tsaG1337/mEFIS/hardware/mainboard_rev.1.1.pdf

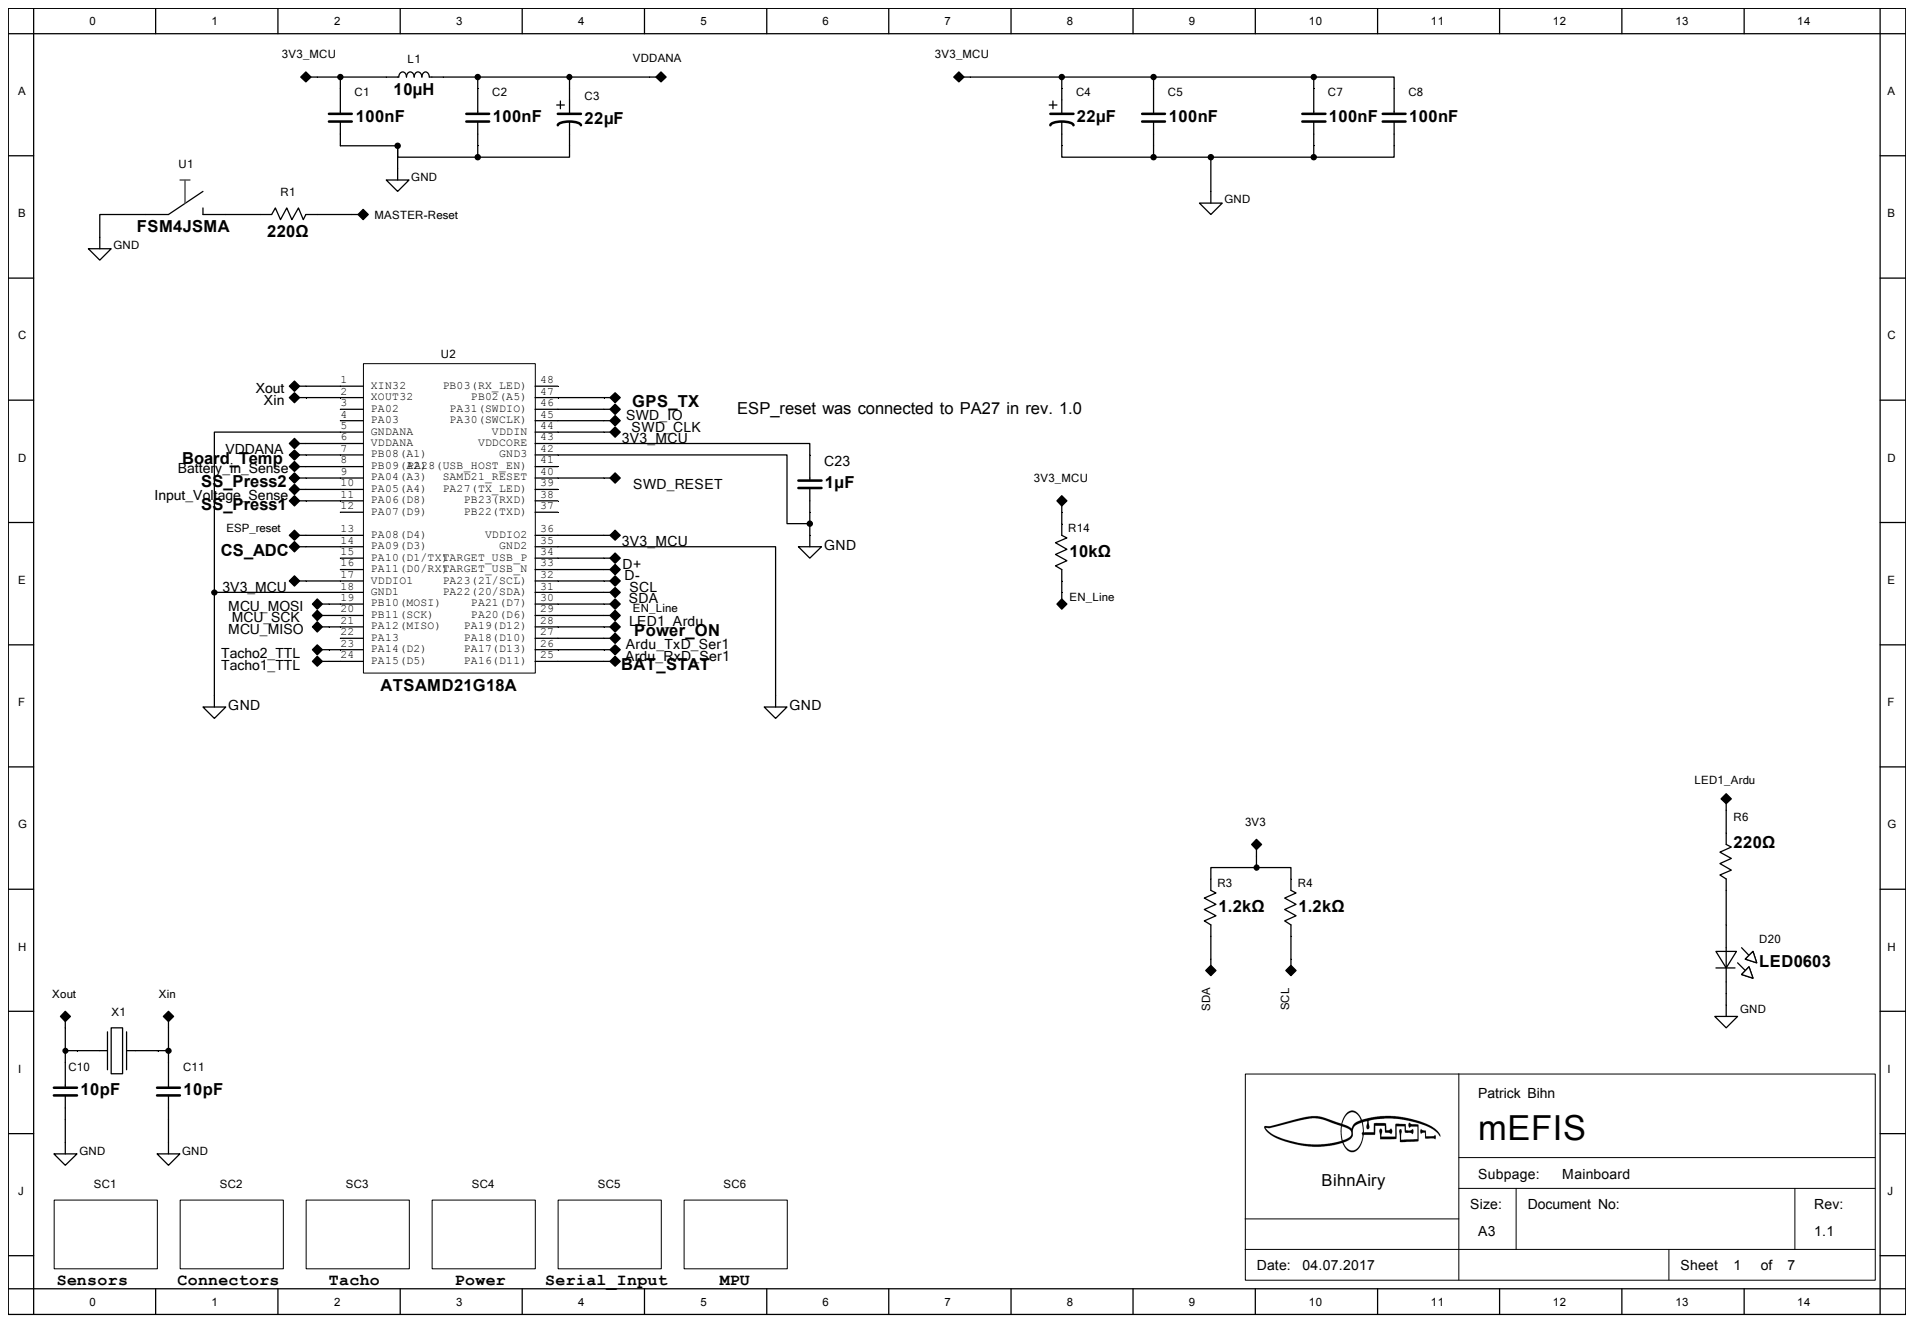
[picture p1: page 1]

ESP_reset was connected to PA27 in rev. 1.0

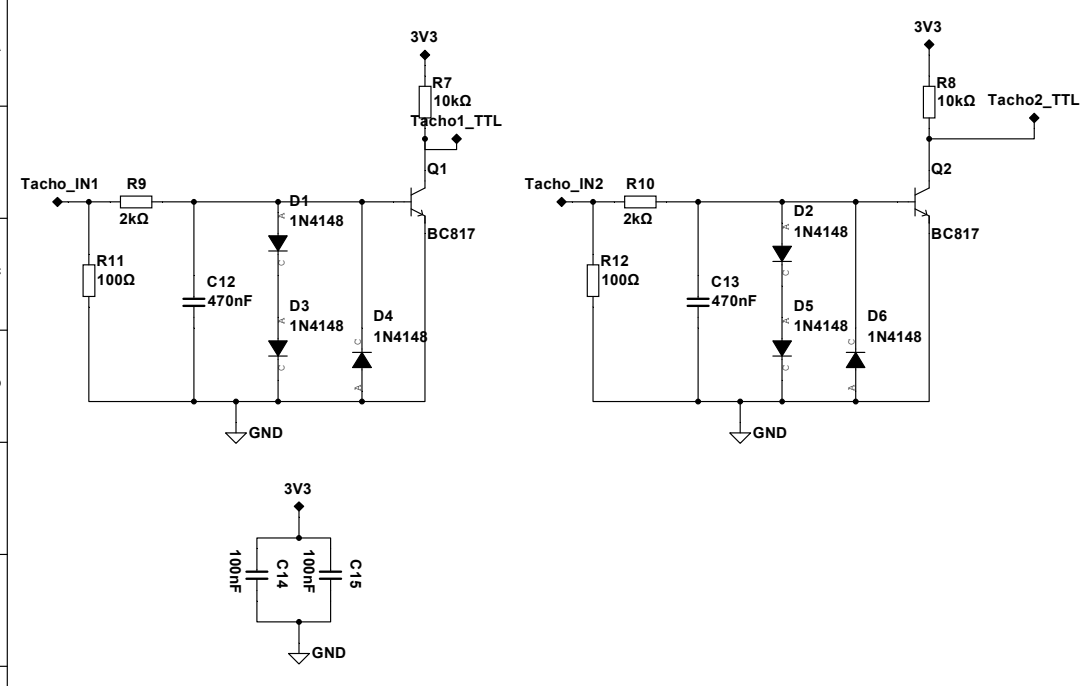
[picture p2: page 2]

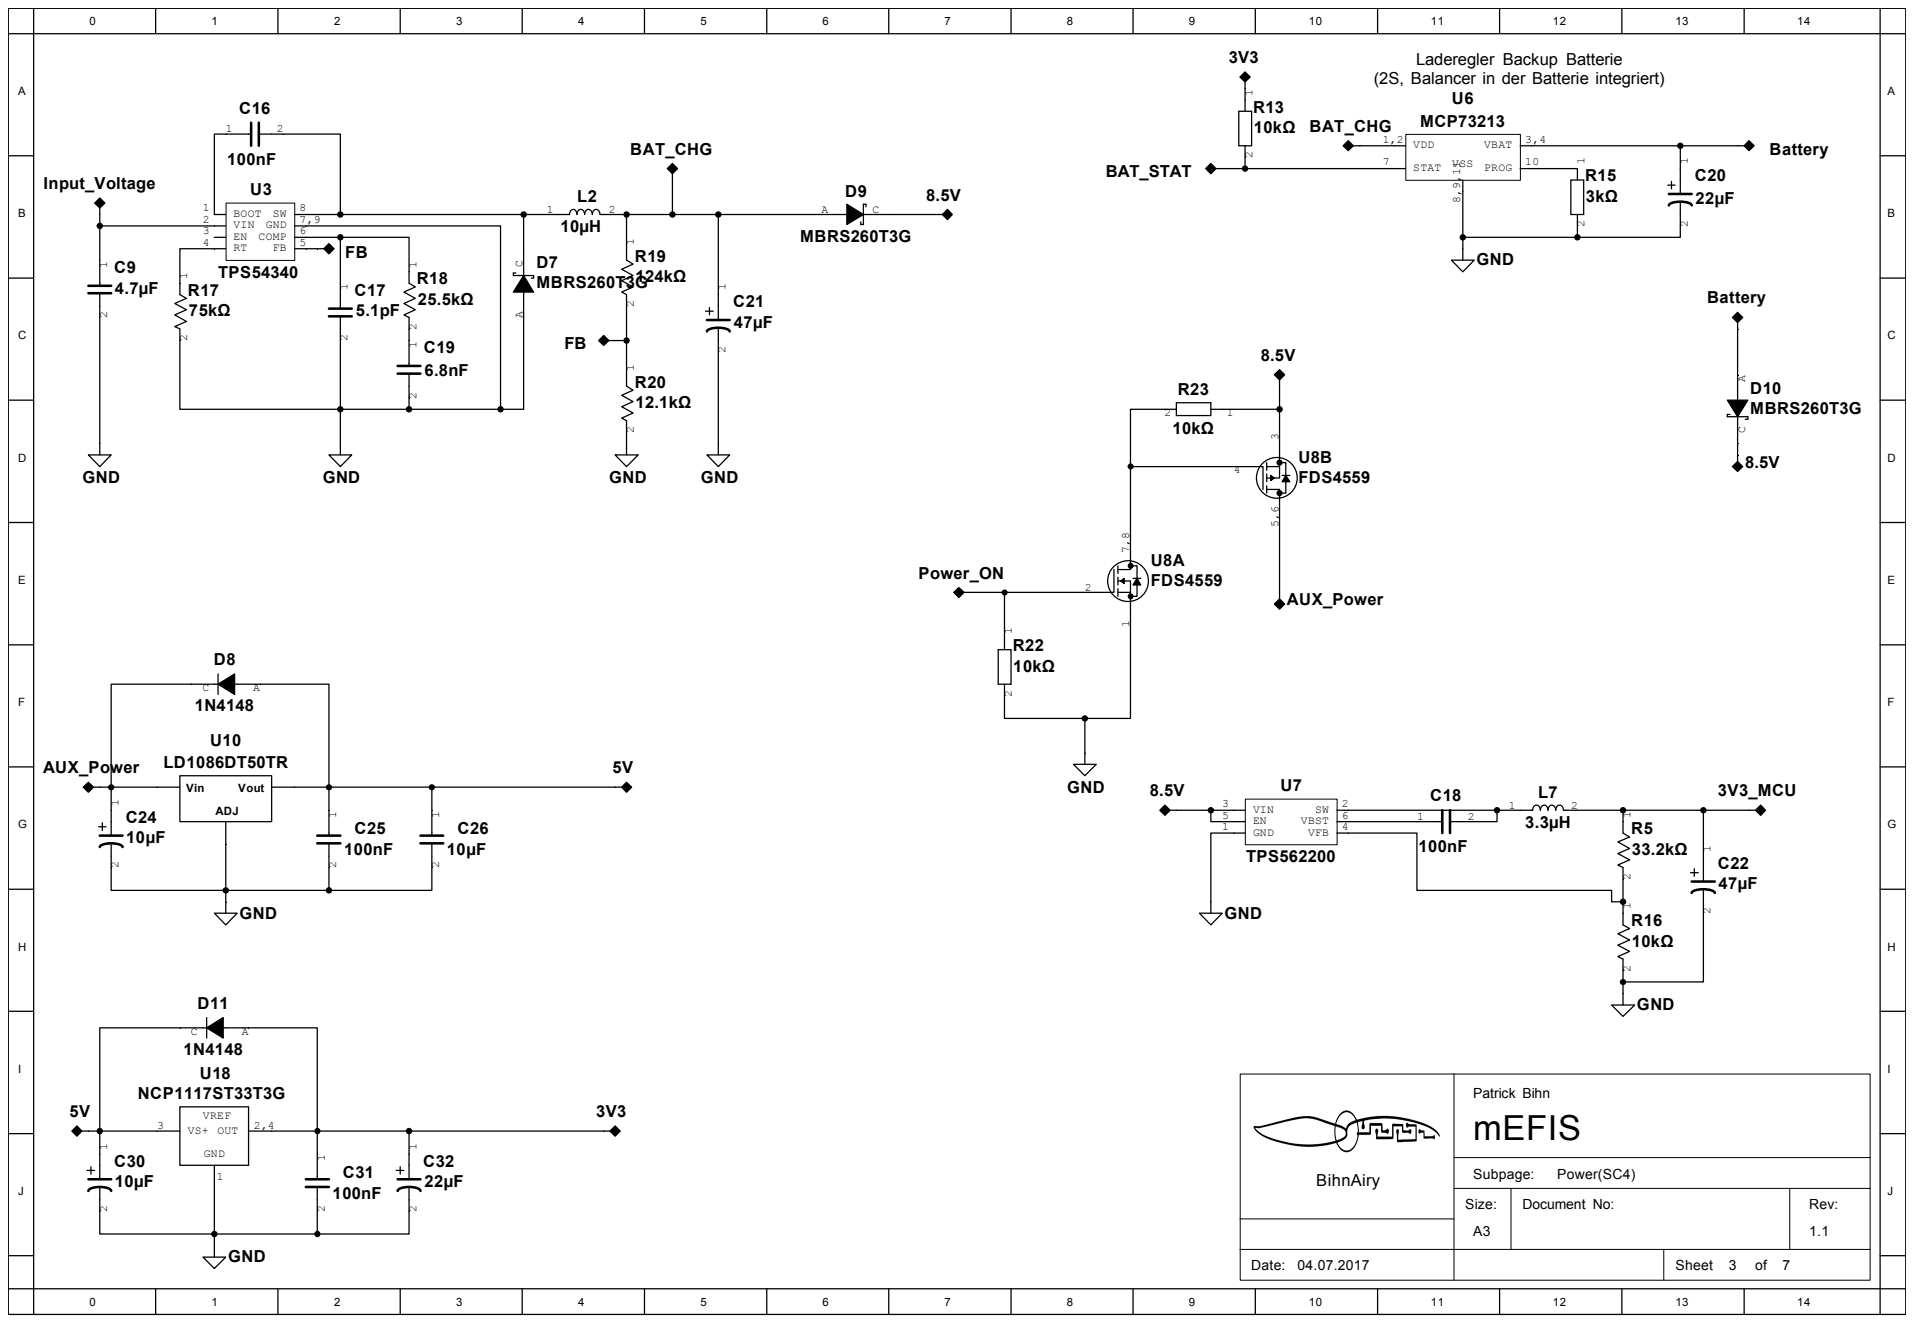
[picture p3: page 3]

(2S, Balancer in der Batterie integriert)

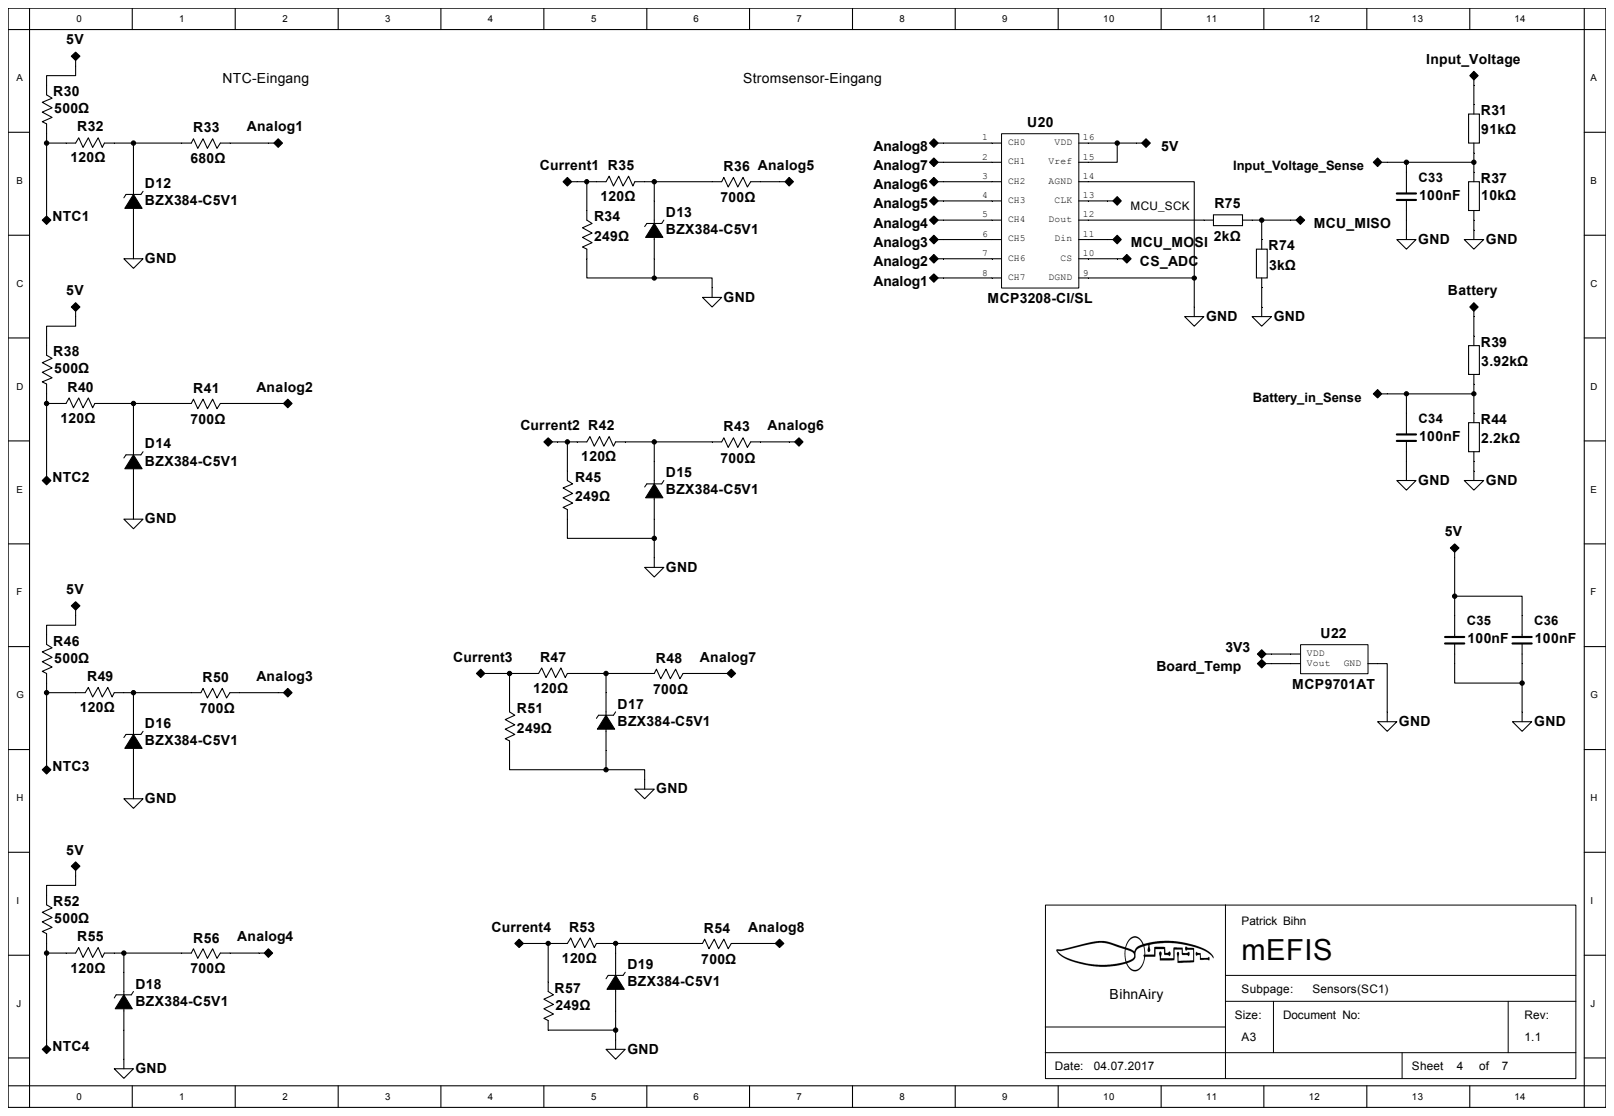
[picture p4: page 4]

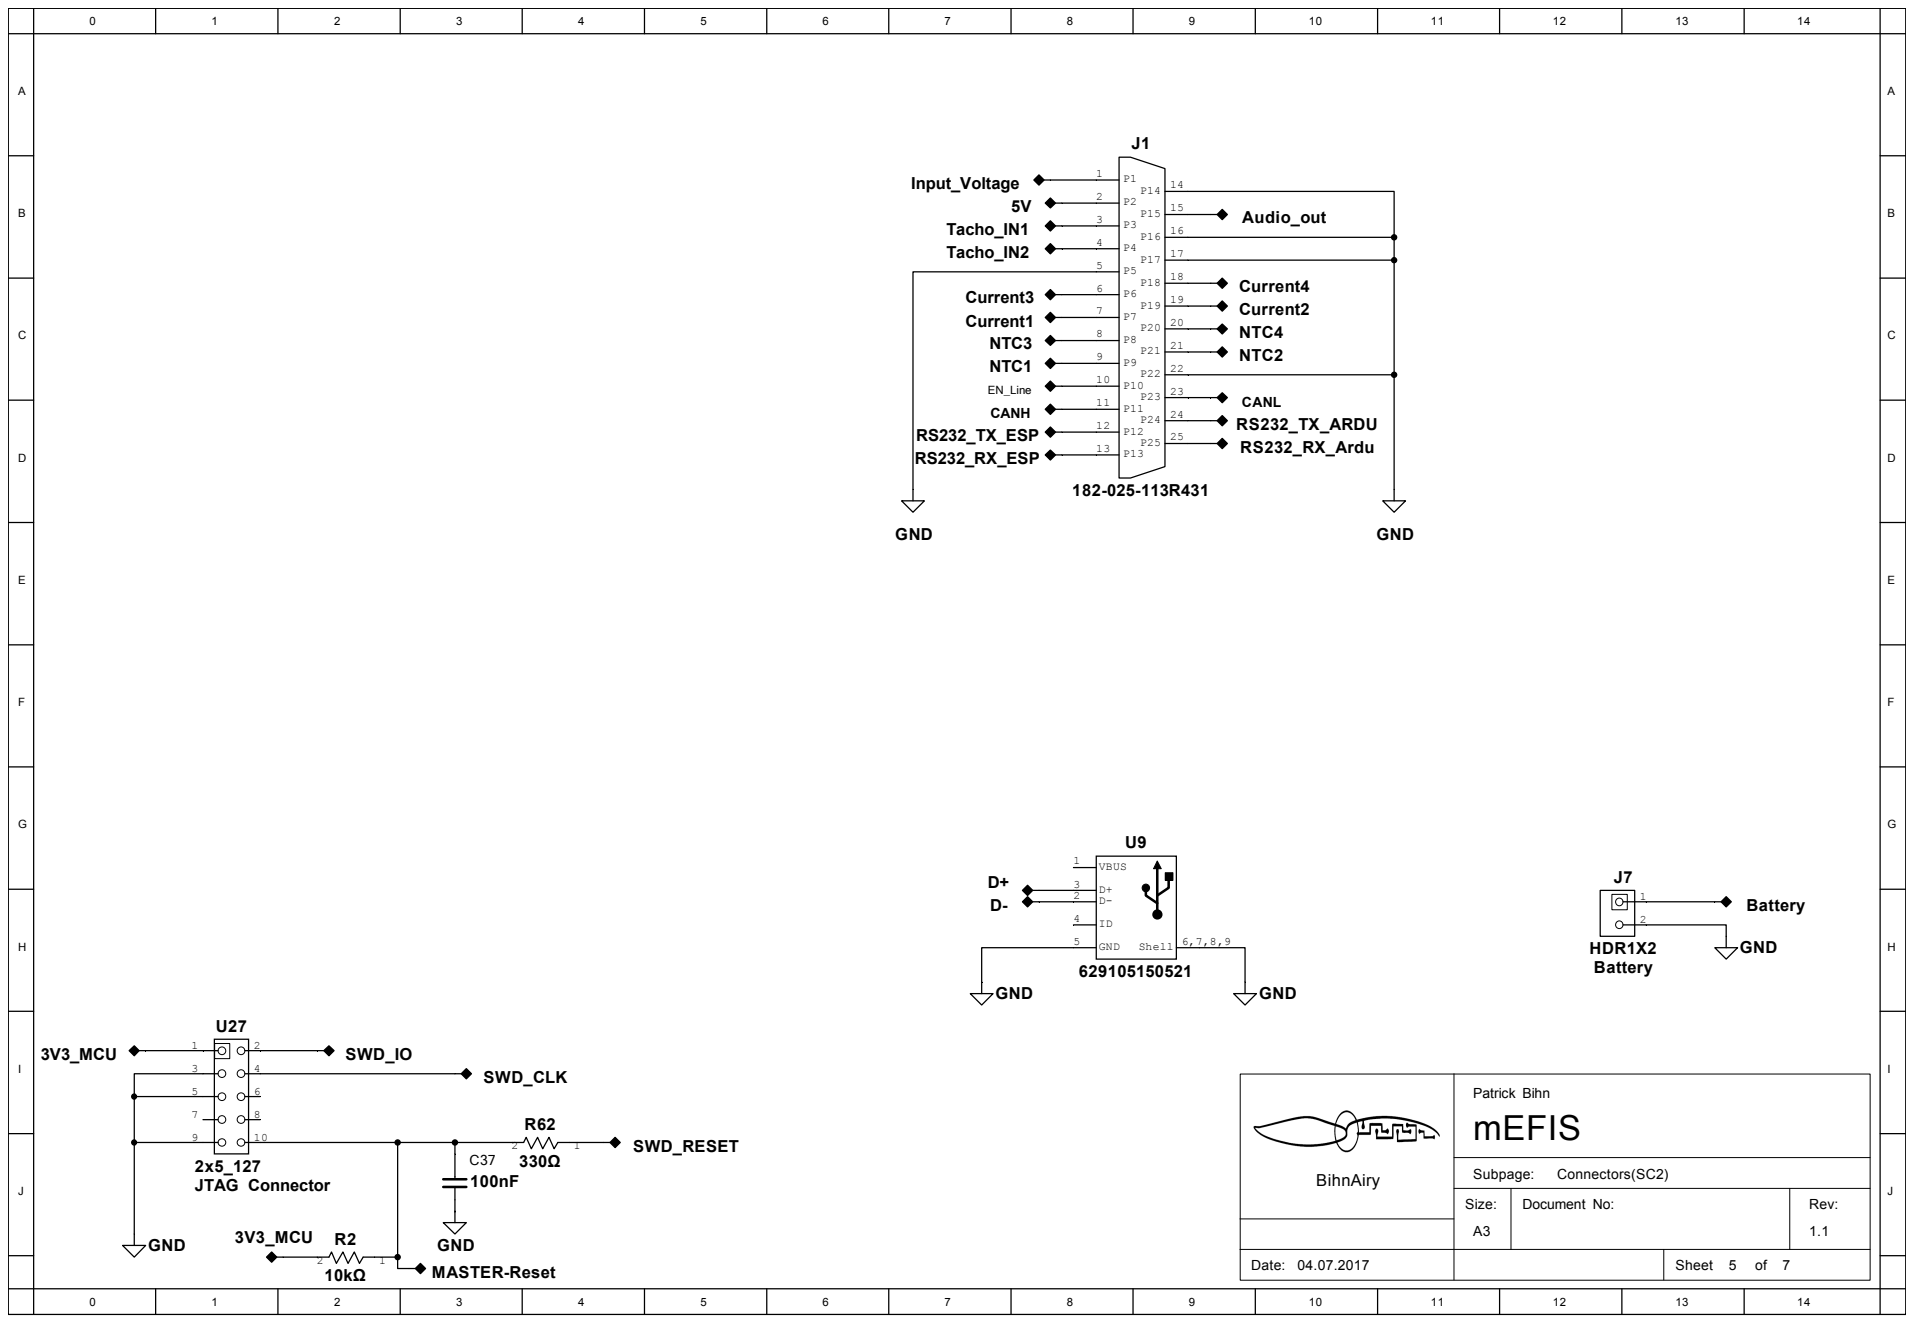
[picture p5: page 5]

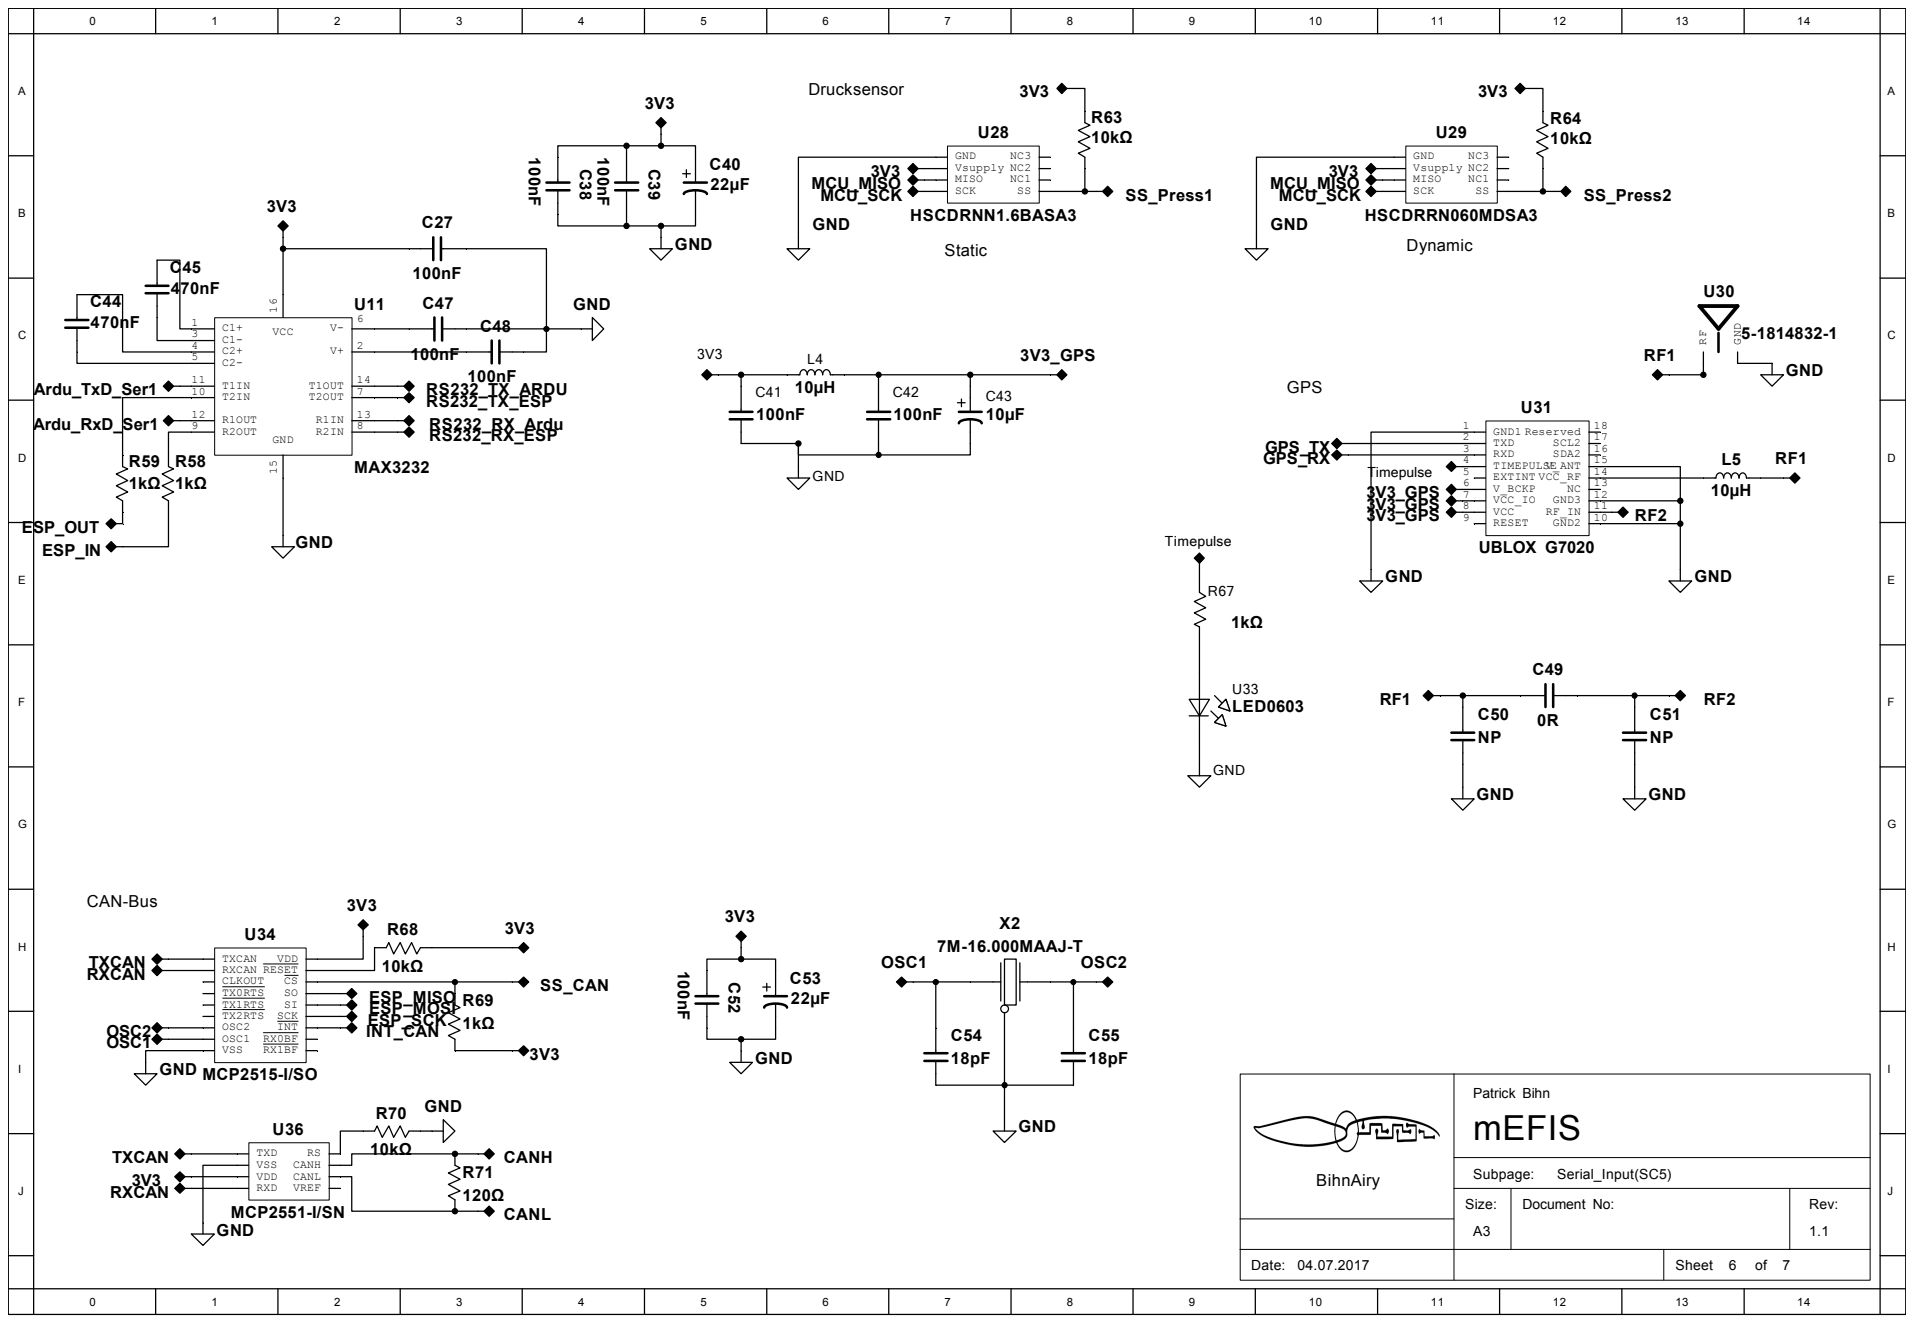
[picture p6: page 6]

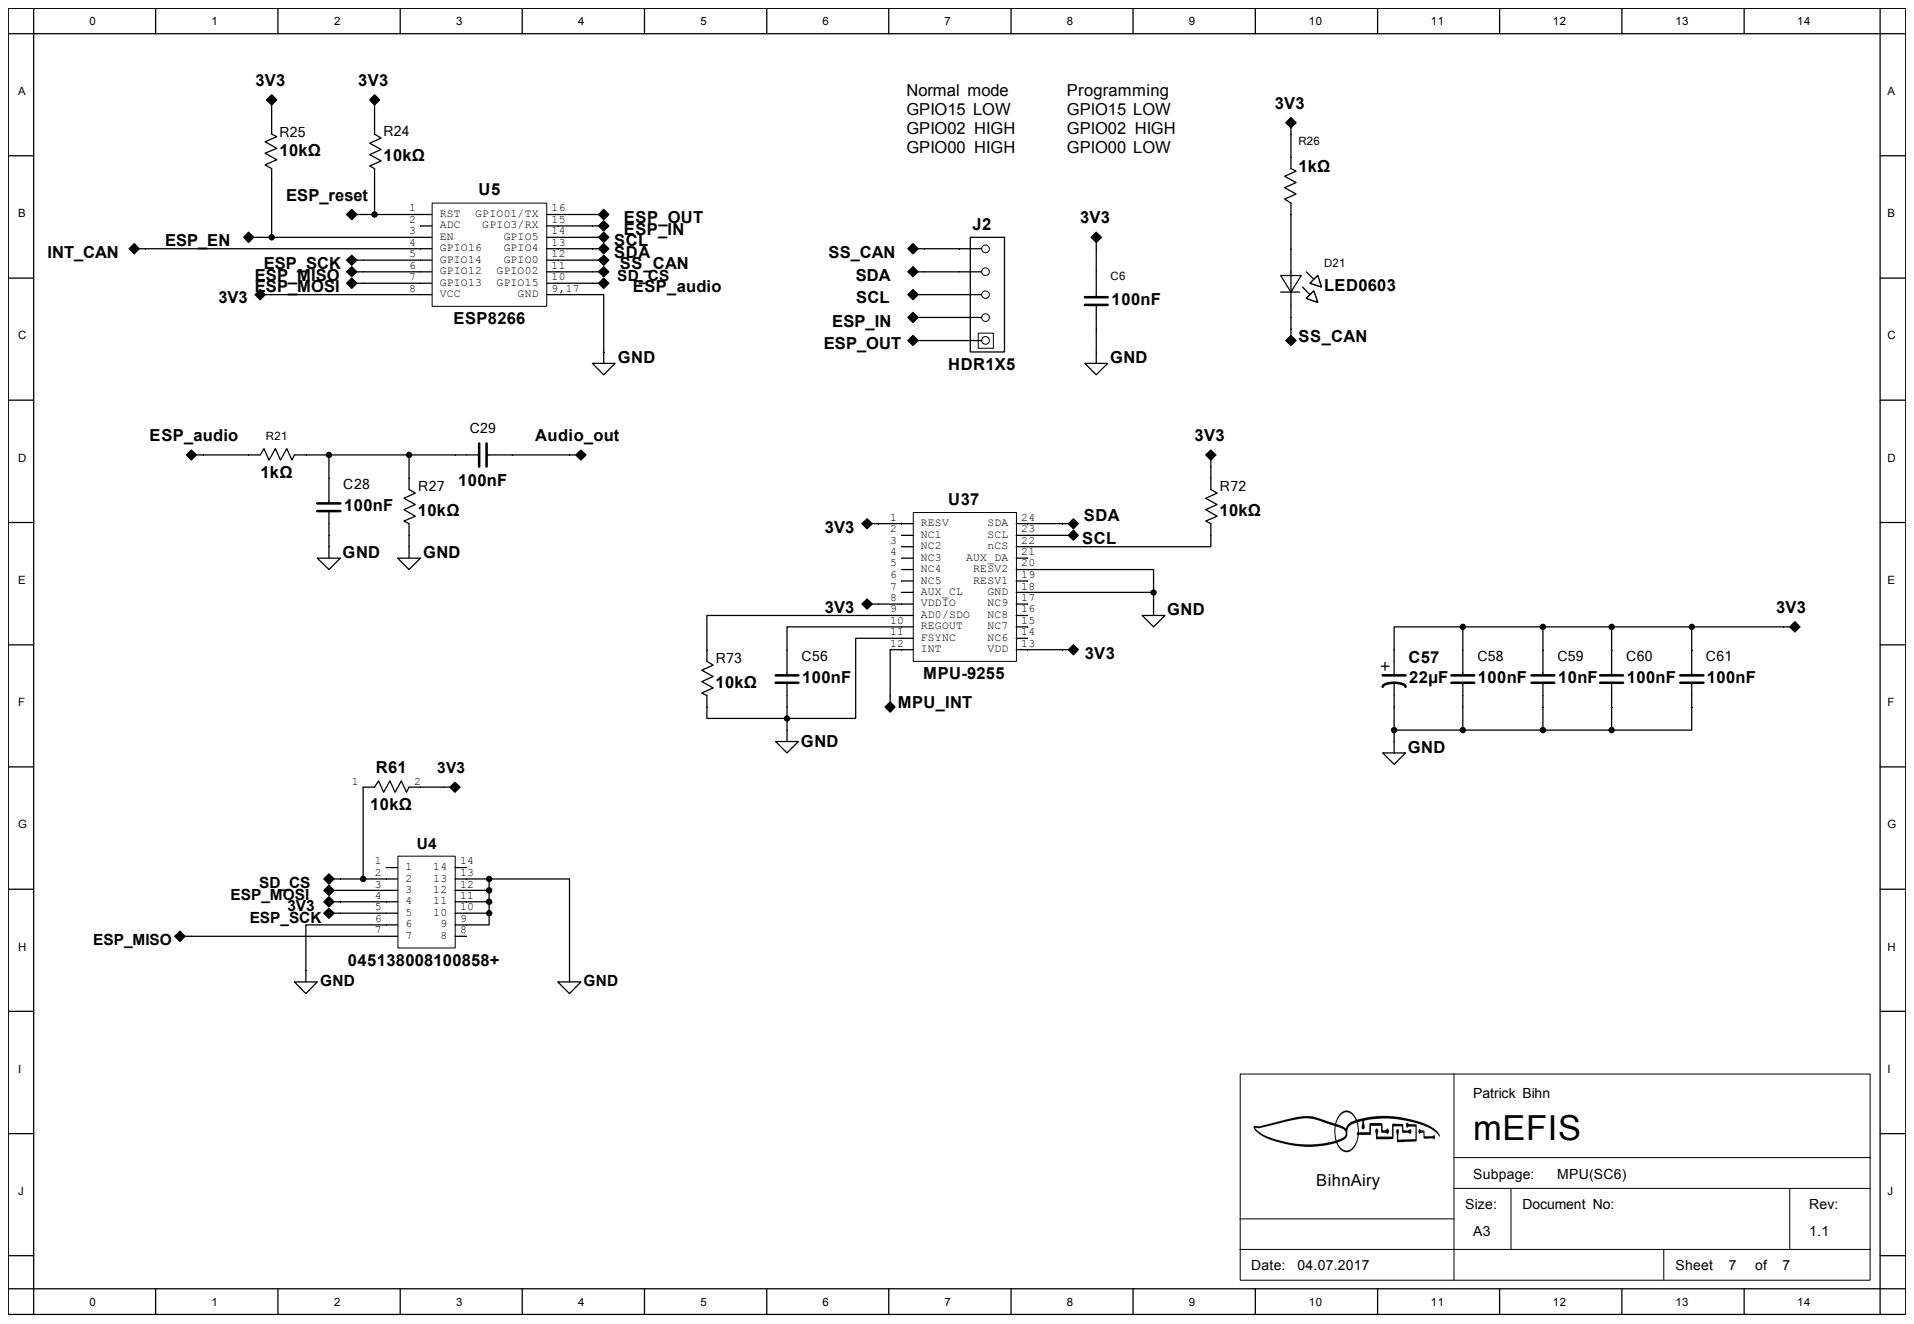
[picture p7: page 7]
