tsaG1337/mEFIS/firmware/dsp_core/HSS.cpp

/*
  mEICAS - my Engine Indicating Crew Alerting System.
  Copyright (C) 2017 Patrick Bihn <pbihn at uni minus bremen dot de>

  You can find the full repo here:
  https://github.com/tsaG1337/mEFIS

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
*/
#include "HSS.h"
#include "Arduino.h"
#include "SPI.h"
#define DEBUG "HSS"
#include "debug.h"

//Define Communication Settings
#define baudrate 500000
#define BitFirst MSBFIRST
#define SPIMode SPI_MODE3



HSS::HSS(uint8_t ChipSelect, int16_t low, int16_t high) {
  lowPressure = low;
  highPressure = high;
  ChipselectPin = ChipSelect;


}


int HSS::getTemperature() {
  return temperature;
}


int16_t HSS::getPressure() {
  return pressure;
}


void HSS::readSensor() {
  SPI.beginTransaction(SPISettings(baudrate, BitFirst, SPIMode)); // Set to 800kHz, MSB and MODE1
  SPI.begin();
  digitalWrite(ChipselectPin, LOW);       //pull Chipselect Pin to Low

  inByte_1 = SPI.transfer(0x00);  // Read first Byte of Pressure
  //delayMicroseconds(10);
  inByte_2 = SPI.transfer(0x00);  // Read second Byte of Pressure
  //delayMicroseconds(10);
  inByte_3 = SPI.transfer(0x00);  // Read first Byte of Temperature
  //delayMicroseconds(10);
  inByte_4 = SPI.transfer(0x00);  // Read second Byte of Temperature
  //LOG("SPI END Transaction");
  SPI.endTransaction();               //end SPI Transaction
  //LOG("SPI END");
  SPI.end();

    //LOG("Chipselect = ",ChipselectPin);
    //LOG("Byte_1 = ",inByte_1);
    //LOG("Byte_2 = ",inByte_2);
    //LOG("Byte_3 = ",inByte_3);
    //LOG("Byte_4 = ",inByte_4);
 
  digitalWrite(ChipselectPin, HIGH);      //pull Chipselect Pin to High
  pressureDigital = inByte_1 << 8 | inByte_2;

  pressure = (((float)(pressureDigital - 1638) * (highPressure - lowPressure)) / 13104) + lowPressure; //transform digital value into real pressure
  inByte_3 = inByte_3 << 3 | inByte_4; //Shift first Temperature byte 3 left
  temperature = ((float)inByte_3 * 200 / 2047) - 50; //Convert Digital value to °C
  //LOG("Temp[C]= ", temperature);

}


void HSS::oversampleReadSensor() {
  float tempBuffer = 0;
  int32_t pressBuffer = 0;
  for (int i = 0; i < sampleRate; i++) {
    readSensor();
    tempBuffer += temperature;
    pressBuffer += pressure;
  }
  temperature = (tempBuffer / sampleRate);
  pressure = (pressBuffer / sampleRate);
}



uint8_t HSS::getSampleRate() {
  return sampleRate;
}

void HSS::setSampleRate(uint8_t newSampleRate) {
  sampleRate = newSampleRate;
}
