tsaG1337/mEFIS/(commit log)

2017-06-17 Fixed Frequency counter
    -reassigned pressure Sensor Pins (remains of the mEICAS)
    -fixed Frequency counter issue
    -added moving average filter to frequency counter
    -added frequency output to I2C register (29 for freq1 and 30 for freq2)
    [dsp_core.ino, movingAverage.h]
2017-06-18 license, comment
    -added Licence header to HSS
    -fixed movingAverage to variable samplesize
    [HSS.cpp, HSS.h, mcp3208.cpp, mcp3208.h, movingAverage.cpp, movingAverage.h]
2017-07-01 Low power mode
    Added a Feature to activate the low power mode. It disables the wifi, GPS, ADC and the Pressure Sensor.
    SS Pins for the Pressure sensor have to be turned to inputs, otherwise they create a short circuit!
    [HSS.cpp, dsp_core.ino, ledFlasher.cpp, ledFlasher.h, main_core.ino, mcp3208.cpp, mcp3208.h]
2017-07-04 Fixed low voltage bug
    [HSS.cpp, HSS.h, dsp_core.ino, ledFlasher.cpp, ledFlasher.h, movingAverage.cpp, movingAverage.h]
2017-07-04 schematic updated
    -swapped ESP_reset to PA08 so the standard Arduino Bootloader can be used. Otherwise the ESP would reset as soon as data was send through USBSerial (On the Arduino Board, PA27 is connected to the USBSerial TX LED).
    -changed Voltage divider for the Battery Voltage.
2017-07-04 workaround for HSS Power Management bug
    -Removed HSS Power Managemen. Sounds good, doesnt work.
    Arduino hung up when switching several times. Still have to inverstigate why. Right now, it is directly implemented into the main code.
    -added debugMessenger to HSS class (doesnt write crap to Serialport anymore.)
    [HSS.cpp, HSS.h, dsp_core.ino]
2017-08-11 disabled debug messages
    Every output on the USB Serial port causes the maincore to reset. Fixed in Hardware Rev 1.1 :)
    [dsp_core.ino]
2017-08-18 added rev1.1 gerber files
2017-08-21 added PowerStatus to I2C transfer
2017-08-21 added spacer
